ItsVince123/HapticInterfaces-BIKE/(list of files, cad)

Other CAD files:
CAD_Axle.prt
CAD_Frame.prt
CAD_Wheel_Front.prt
CAD_Wheel_Rear.prt
