ItsVince123/HapticInterfaces-BIKE/(commit log)

2026-05-29 Clarify prototype limitations and add mounting note
    Updated the limitations section to clarify that the prototype is built on a scaled bicycle and added a new limitation regarding hardware mounting.
2026-05-29 Revise mounting details and future development plans
    Updated mounting instructions for hardware on a full-scale bike and expanded future development directions, including app integration and sensor upgrades.
2026-05-29 Include schematic images in README
    Added schematic images for Micro and Uno to README.
2026-05-29 Update README with code references for Arduino sketches
    Added code references for Arduino sketches related to the Concurrency Engine and Adaptive IMU Algorithm sections.
2026-05-29 Refine explanation of microcontroller processing load
    Clarified the processing load distribution between the Arduino Uno and Micro, emphasizing the constraints faced during development.
